makerspet/pcb/pico_breakout_head/README.md

# Raspberry Pi Pico Head Breakout PCB for Maker's Pet robots

## Files
- [schematic PDF](output/pico_breakout_head_schematic.pdf)
- [BoM .CSV](output/pico_breakout_head_bom.csv), [BoM .XML](output/pico_breakout_head_bom.xml)
- [Gerber .ZIP](output/pico_breakout_head_gerber.zip)
- [3D model .STEP](output/pico_breakout_head.step)
- KiCAD schematic, layout - in this folder

## Top
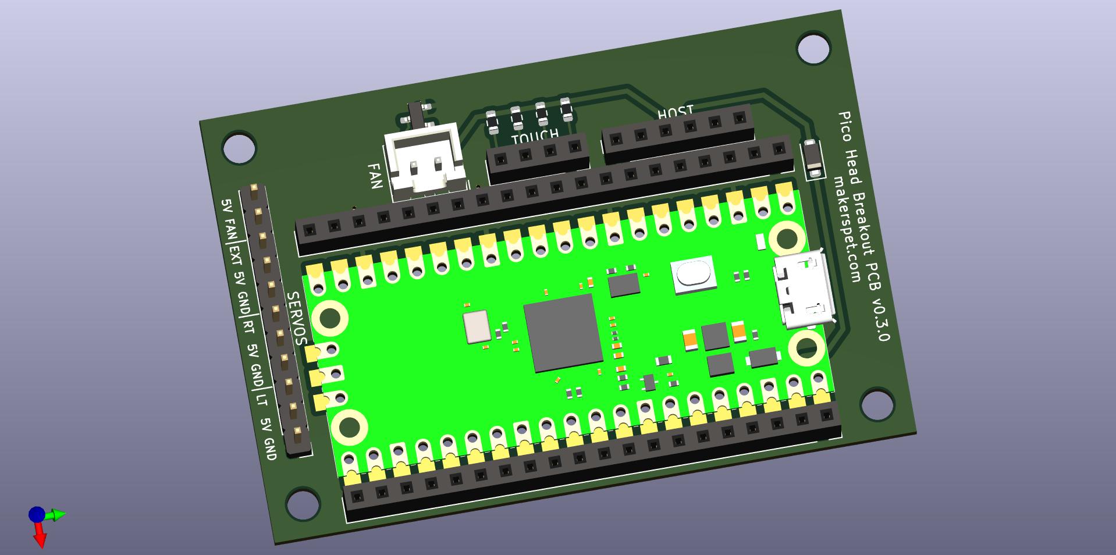
[picture p1: pico_breakout_head/output/pico_breakout_head_top.jpg]


## Bottom
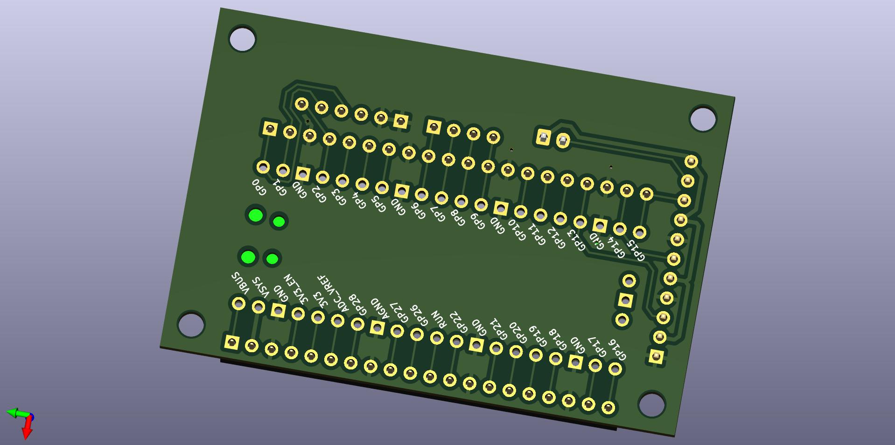
[picture p2: pico_breakout_head/output/pico_breakout_head_bottom.jpg]


# Change log

## v0.3.0
- DuPont host connector
- single side assembly
- alternative fan DuPont connection

## v0.2.1
- changed host connector from JST PH to JST ZH
- bugfix servo, touch sockets to headers

## v0.2.0
- fan N-MOSFET fix
- removed fan diode
  - unnecessary for such a small motor

## v0.1.1
- use same diode components
- removed fan MOSFET gate resistor

## v0.1
- I2C host interface connector
- fan connector
- connector for 3 servos
  - left and right ears plus one extra
- touch connector with 4 segments
