makerspet/pcb/lds02rr_adapter/README.md

# Adapter PCB for LDS02RR laser distance scanner

Connect these LiDARs/LDS to Arduino to capture laser distance data:
- Xiaomi LDS02RR
- Xiaomi LDS01RR

This PCB implements PWM motor control for LDS02RR, LDS01RR. Find
sample Arduino ESP32 firmware code [here](https://github.com/kaiaai/LDS02RR_ESP32).

## Files
- [schematic PDF](output/LDS02RR_adapter_schematic.pdf)
- [BoM .CSV](output/LDS02RR_adapter_BoM.csv), [BoM .XML](output/LDS02RR_adapter_BoM.xml)
- [Gerber .ZIP](output/LDS02RR_adapter_gerber.zip)
- [3D model .STEP](output/LDS02RR_adapter.step)
- KiCAD schematic, layout - in this folder

<a href="http://www.youtube.com/watch?feature=player_embedded&v=Wes9GYomUdE" target="_blank">
 Xiaomi LDS02RR streams live data to ROS2 using Arduino ESP32 and Micro-ROS
</a>

## Top
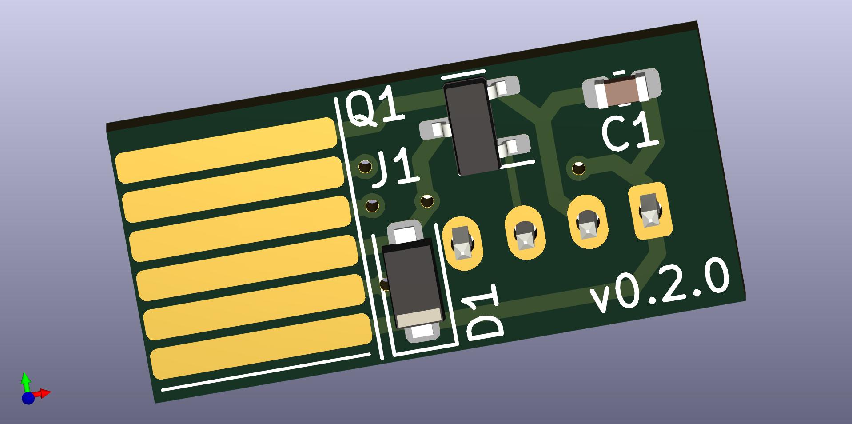
[picture p7: lds02rr_adapter/output/LDS02RR_adapter_top.jpg]


## Bottom
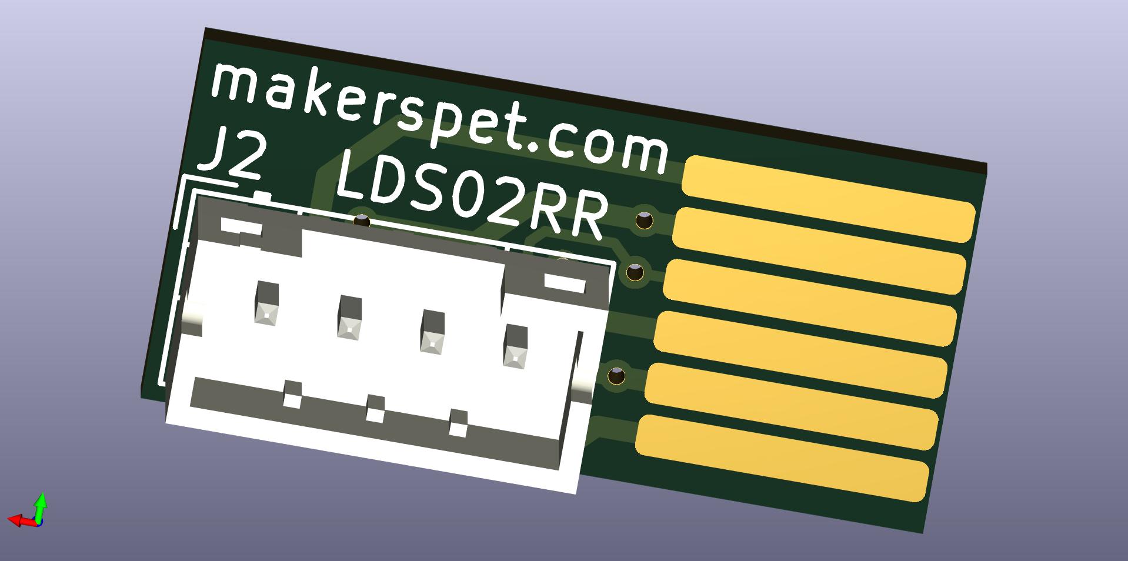
[picture p8: lds02rr_adapter/output/LDS02RR_adapter_bottom.jpg]


# Change log

## v0.2.1
- changed bypass cap from 100uF 1206 to 22uf 0603

## v0.2.0
- added a bypass cap

## v0.1.0
- initial prototype
- PCB inserts into LDS02RR connector
- 4-pin JST PH connector - 5V, GND, LDS motor PWM, LDS TX
