makerspet/pcb/esp32_combined_terminals/output/esp32_combined_bottom.jpg

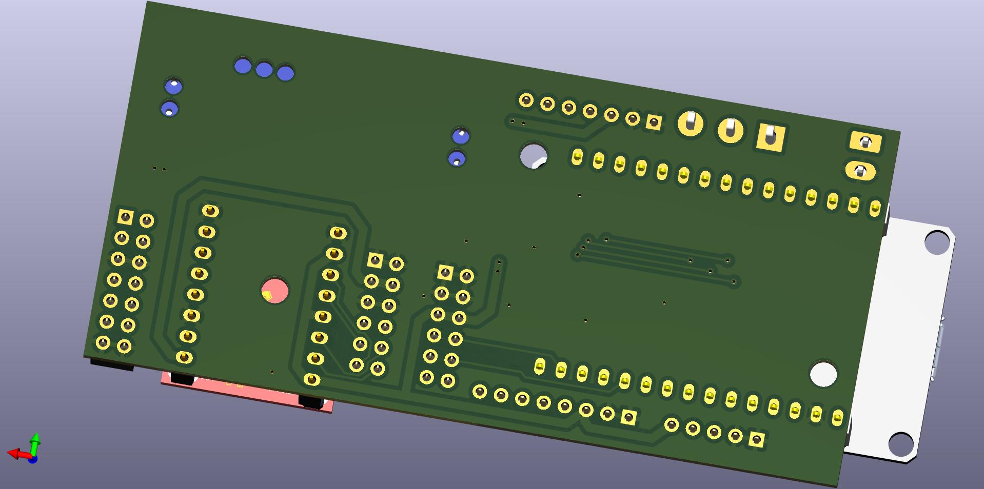
esp32_combined_terminals/output/esp32_combined_bottom.jpg
