makerspet/pcb/esp32_combined_terminals/output/esp32_combined_top.jpg

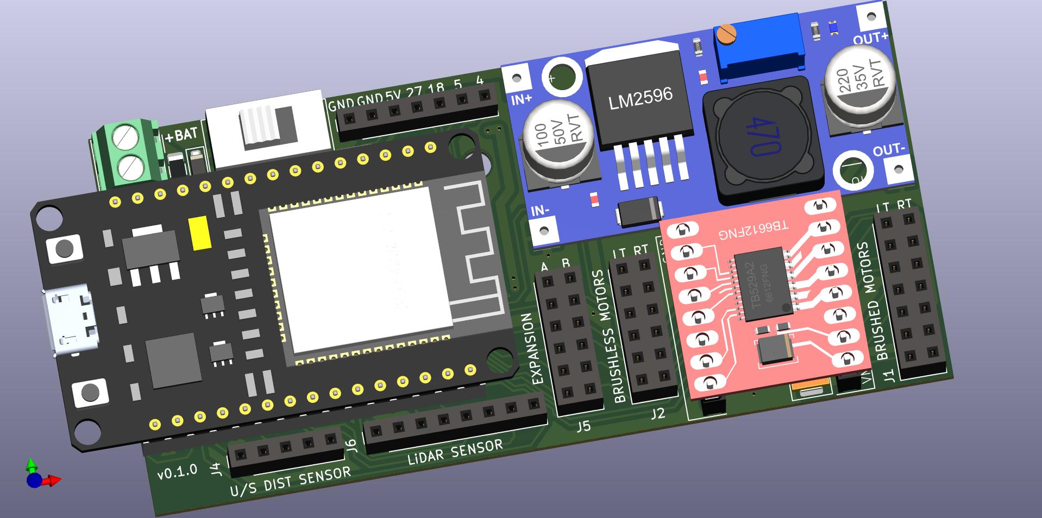
esp32_combined_terminals/output/esp32_combined_top.jpg
