makerspet/pcb/mini_/output/esp32_combo_bottom.jpg

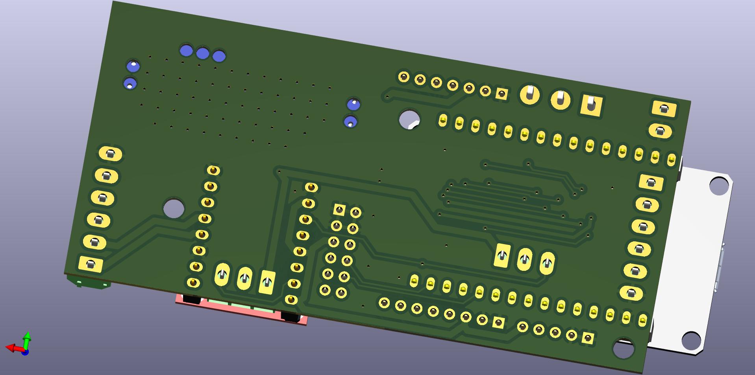
mini_/output/esp32_combo_bottom.jpg
