makerspet/pcb/hls_adapter/output/hls_adapter.step

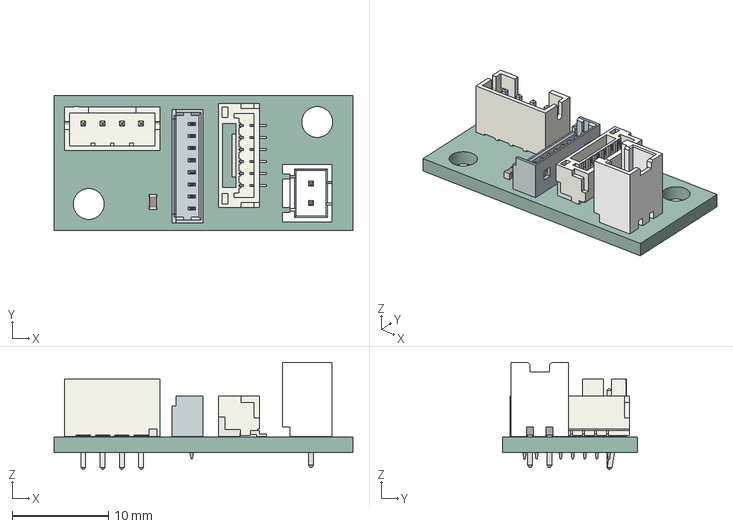
[picture p12: CAD file, 2024-03-07]
hls_adapter/output/hls_adapter.step
31.0 x 14.0 x 11.1 mm
hls_adapter PCB
