makerspet/pcb/lds02rr_adapter/output/LDS02RR_adapter.step

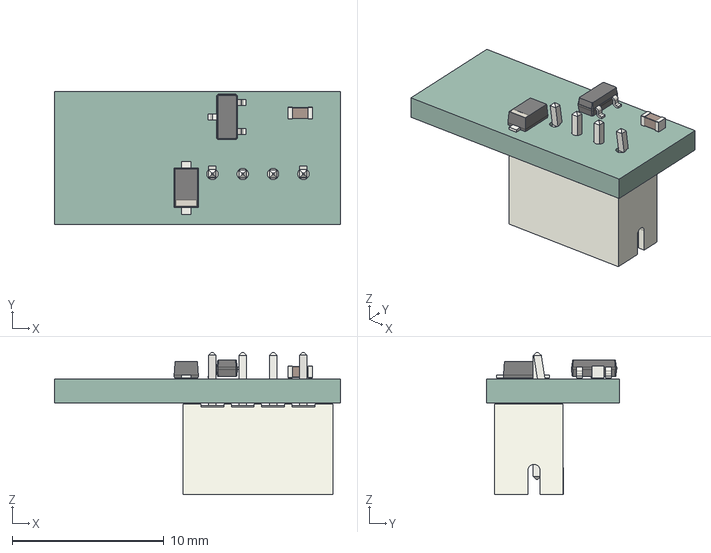
[picture p13: CAD file, 2024-03-07]
lds02rr_adapter/output/LDS02RR_adapter.step
18.9 x 8.80 x 9.40 mm
LDS02RR_adapter PCB
