makerspet/pcb/step/PCB_Terminal_Block_2-P3.5.step

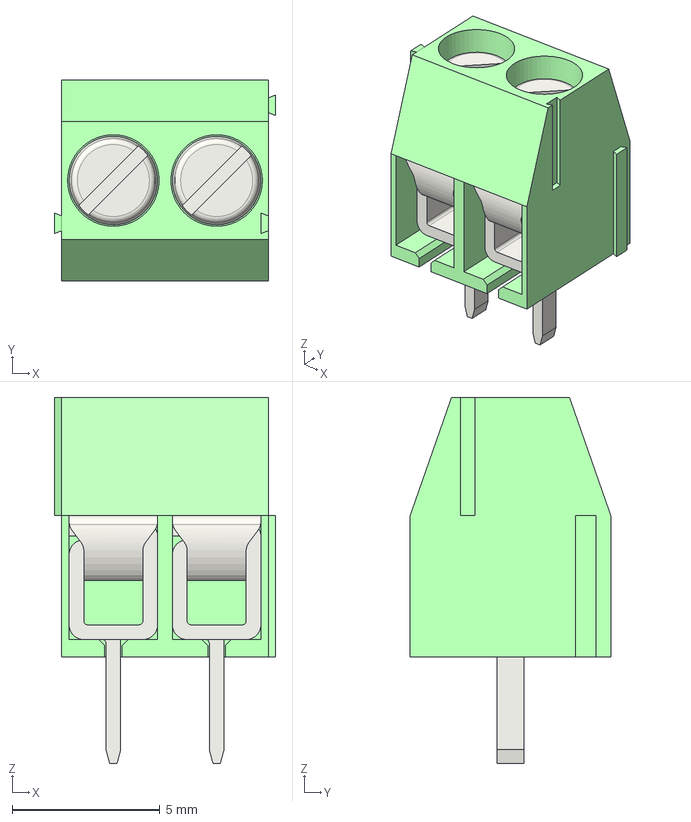
[picture p14: CAD file, 2024-04-06]
step/PCB_Terminal_Block_2-P3.5.step
7.50 x 6.80 x 12.4 mm
M1.6x4-Screw030
