makerspet/pcb/step/PCB_Terminal_Block_6-P3.5.step

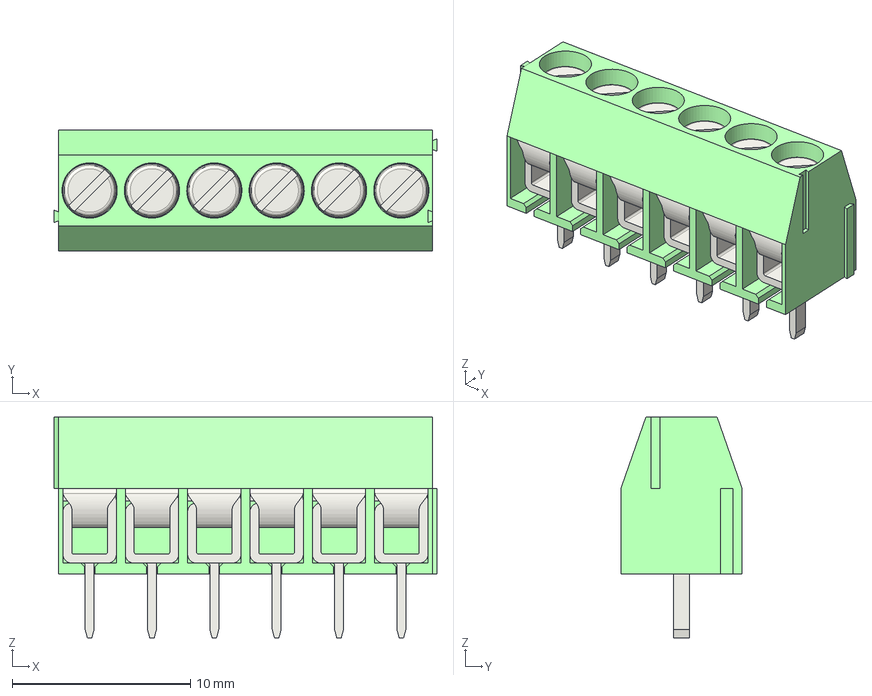
[picture p15: CAD file, 2024-04-06]
step/PCB_Terminal_Block_6-P3.5.step
21.5 x 6.80 x 12.4 mm
M1.6x4-Screw038
