makerspet/pcb/step/PCB Terminal Block 2 DEG381-3.5.step

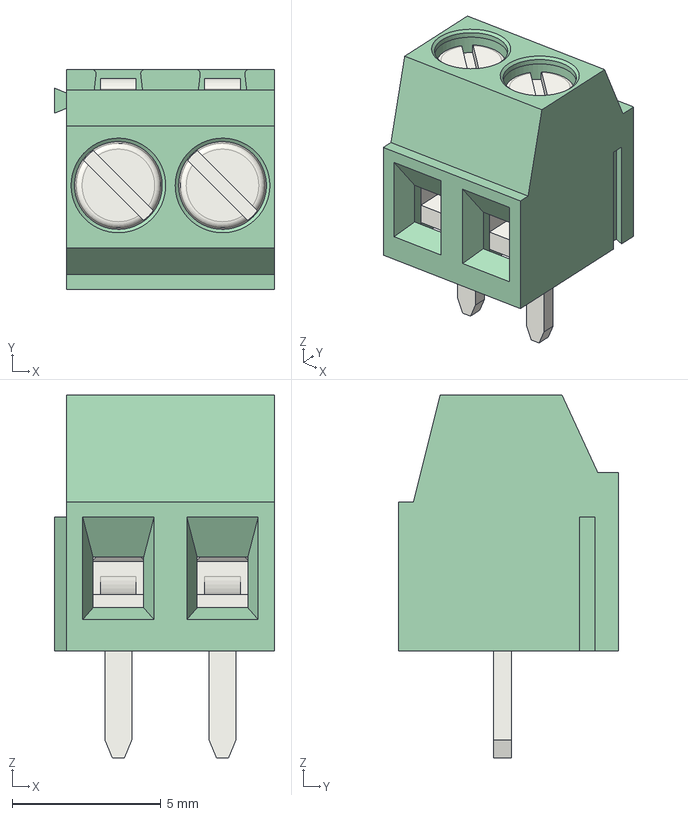
[picture p18: CAD file, 2024-03-29]
step/PCB Terminal Block 2 DEG381-3.5.step
7.40 x 7.40 x 12.2 mm
Plastic Housing001
Pin 002
Clamp Block001
M1.6x3-Screw001
