makerspet/pcb/step/Molex_PicoBlade_53047_0810.stp

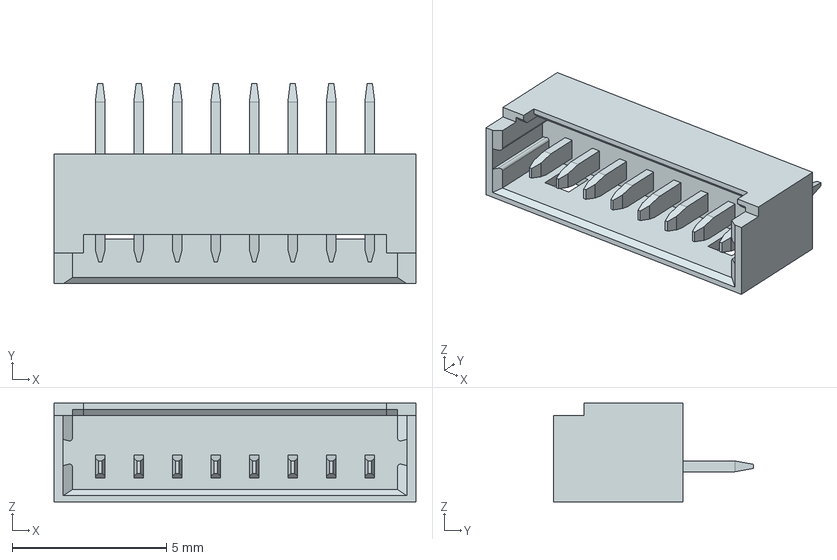
[picture p19: CAD file, 2024-02-16]
step/Molex_PicoBlade_53047_0810.stp
11.8 x 6.50 x 3.20 mm
