makerspet/pcb/step/smw200-02-socket-th-vertical.stp

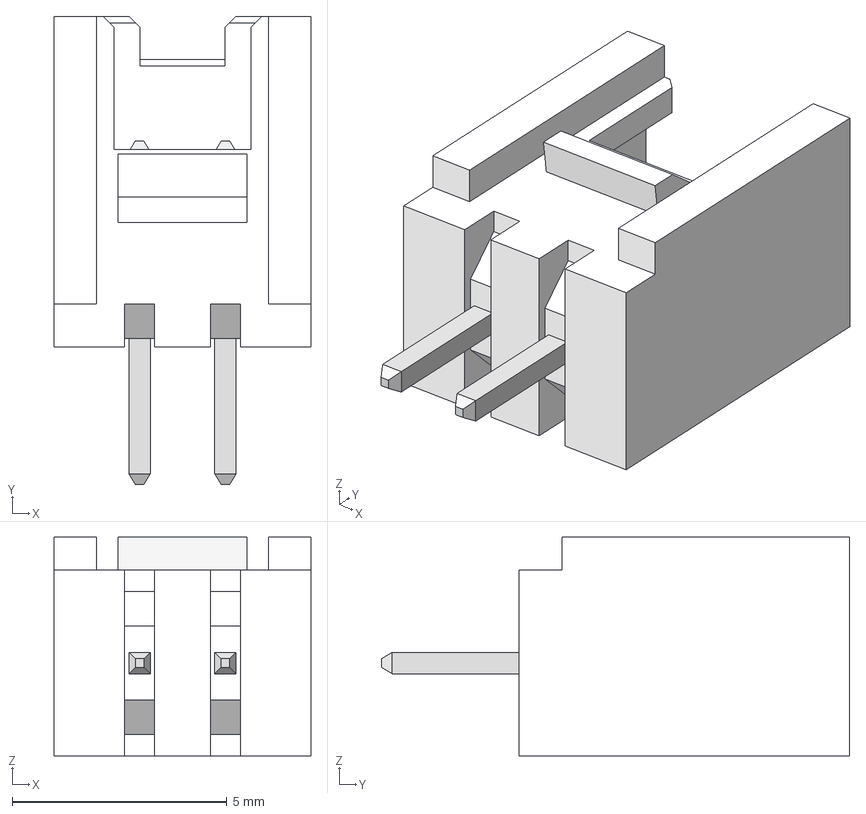
[picture p20: CAD file, 2024-02-13]
step/smw200-02-socket-th-vertical.stp
5.98 x 10.9 x 5.10 mm
