makerspet/pcb/step/SS14LW.step

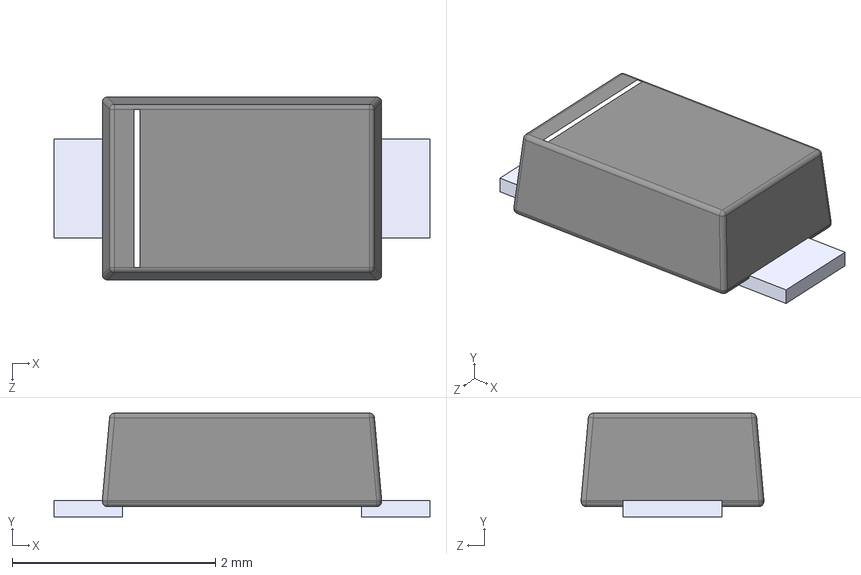
[picture p21: CAD file, 2024-01-23]
step/SS14LW.step
3.70 x 1.02 x 1.80 mm
