makerspet/pcb/step/JST-B11B-ZR.step

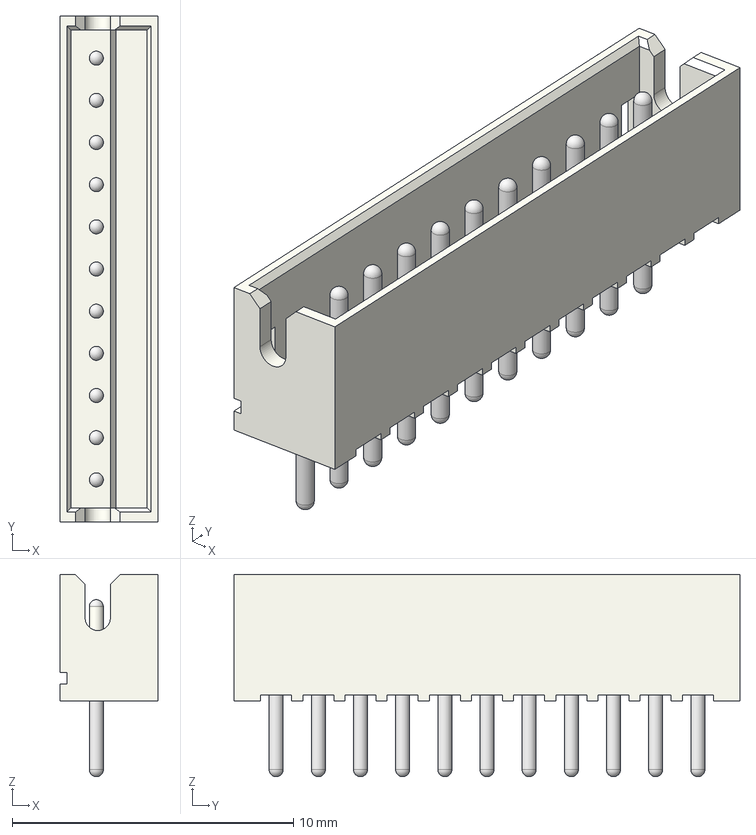
[picture p22: CAD file, 2024-01-23]
step/JST-B11B-ZR.step
3.50 x 18.0 x 7.20 mm
