makerspet/pcb/step/kicad_module_3D_MINI560.step

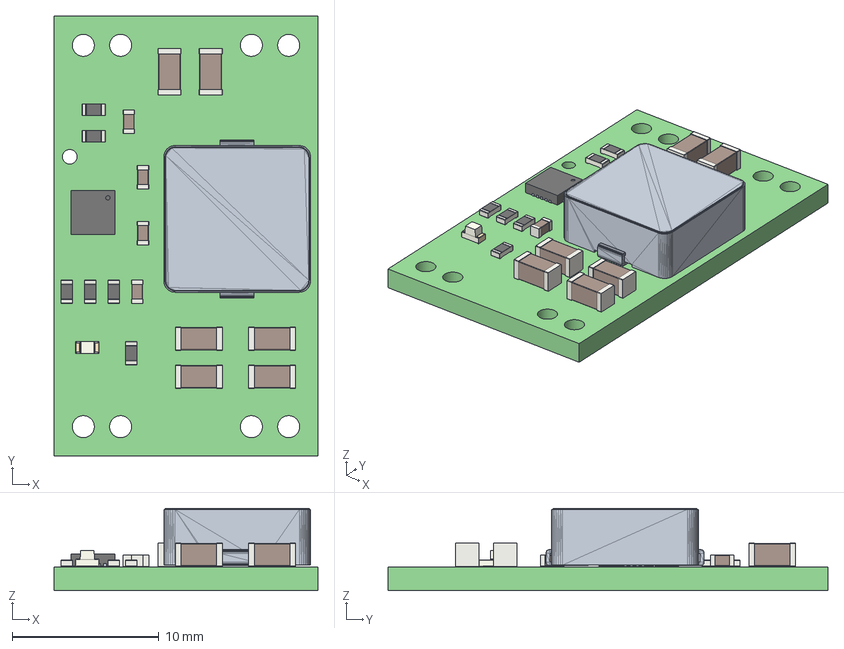
[picture p23: CAD file, 2024-01-23]
step/kicad_module_3D_MINI560.step
18.0 x 30.0 x 5.62 mm
kicad_module_3D_MINI560 PCB
