makerspet/pcb/step/JST-B5B-ZR.step

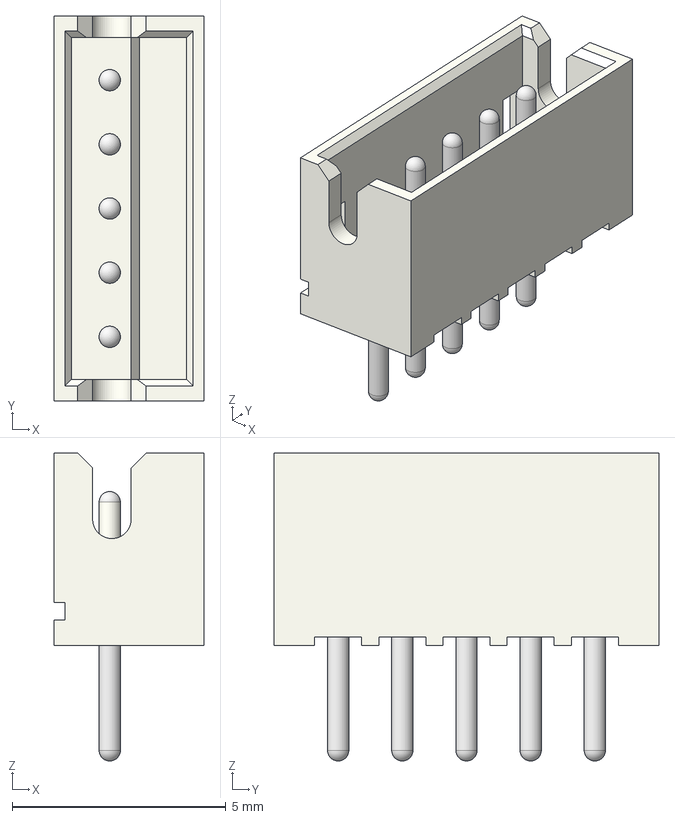
[picture p24: CAD file, 2024-01-23]
step/JST-B5B-ZR.step
3.50 x 9.00 x 7.20 mm
