makerspet/pcb/step/JST-B7B-ZR.step

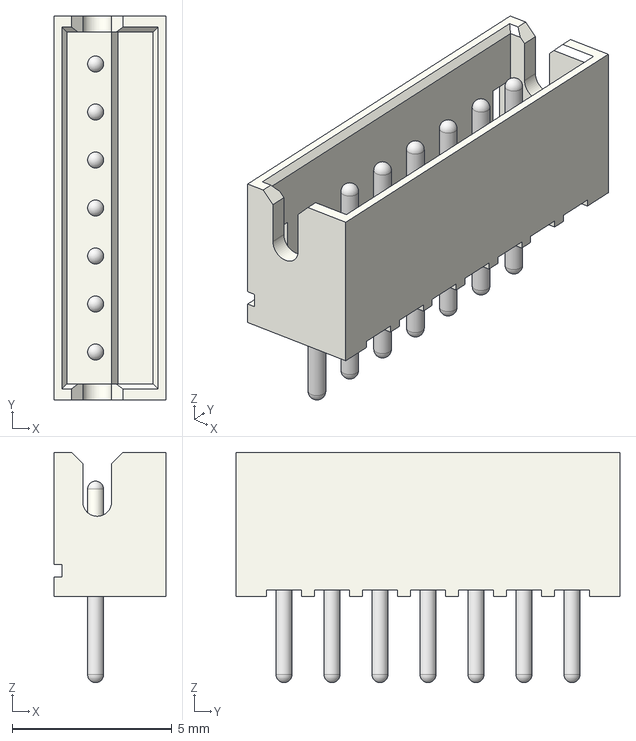
[picture p25: CAD file, 2024-01-23]
step/JST-B7B-ZR.step
3.50 x 12.0 x 7.20 mm
