makerspet/pcb/step/T-Plug male - W.S Deans Co. Est. 1957.step

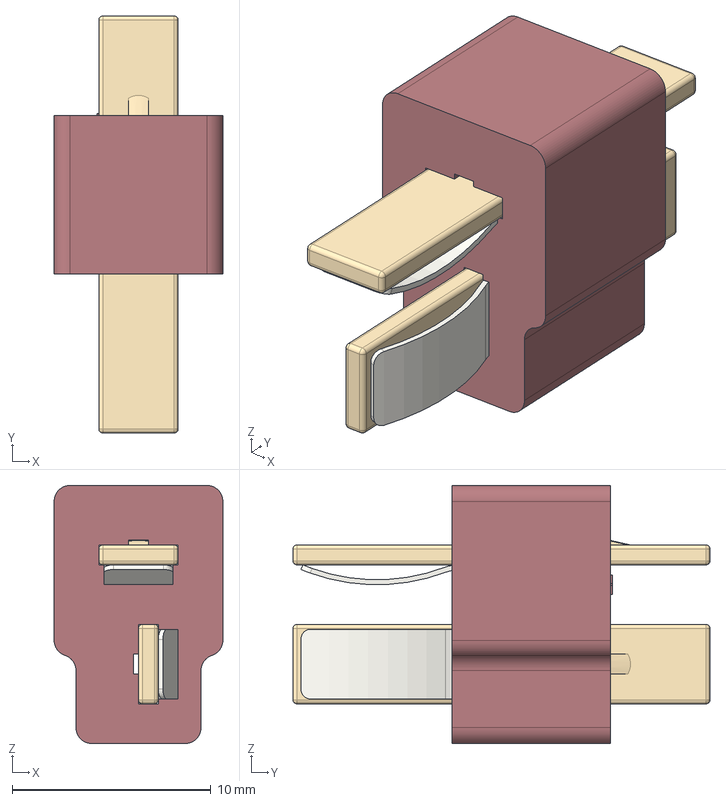
[picture p26: CAD file, 2024-01-23]
step/T-Plug male - W.S Deans Co. Est. 1957.step
8.50 x 21.0 x 13.0 mm
