makerspet/pcb/step/T-Plug female - W.S Deans Co. Est. 1957.step

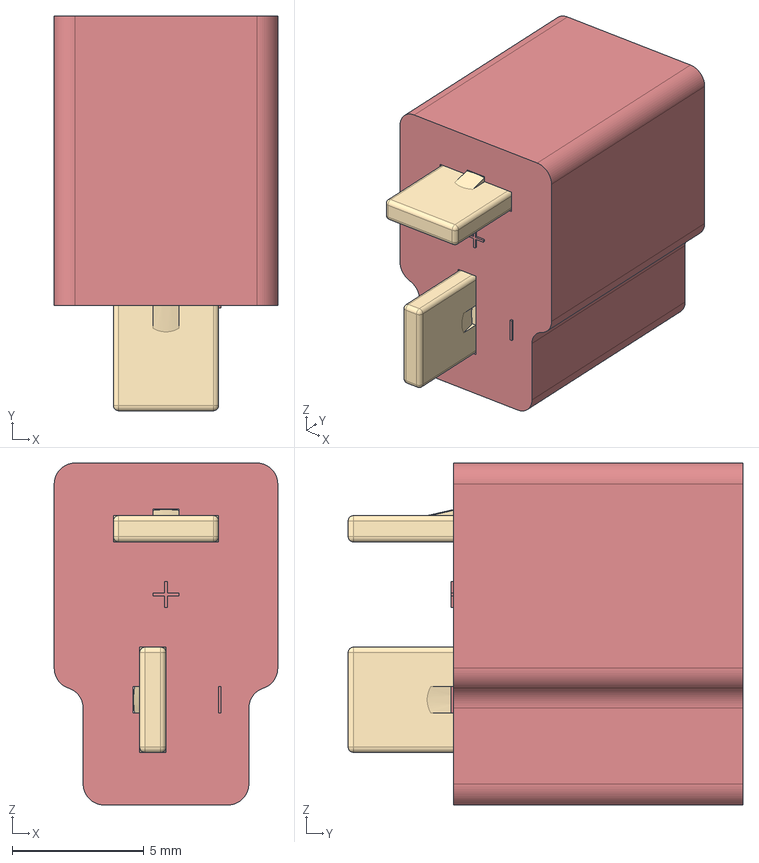
[picture p27: CAD file, 2024-01-23]
step/T-Plug female - W.S Deans Co. Est. 1957.step
8.50 x 15.0 x 13.0 mm
