makerspet/pcb/step/JST-B3B-ZR.step

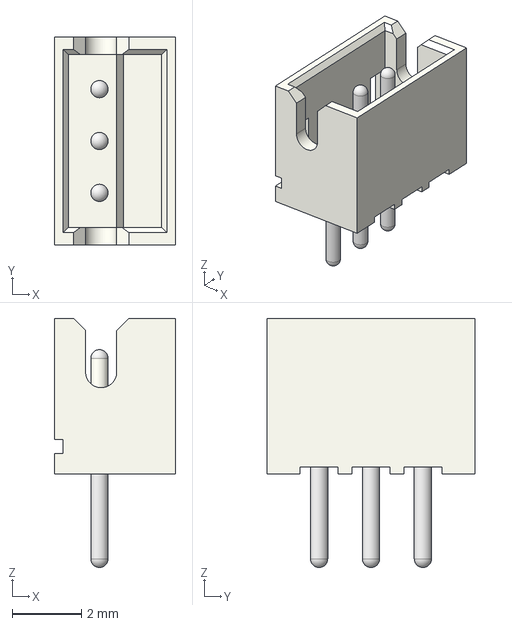
[picture p28: CAD file, 2024-01-23]
step/JST-B3B-ZR.step
3.50 x 6.00 x 7.20 mm
