makerspet/pcb/step/JST-B12B-ZR.step

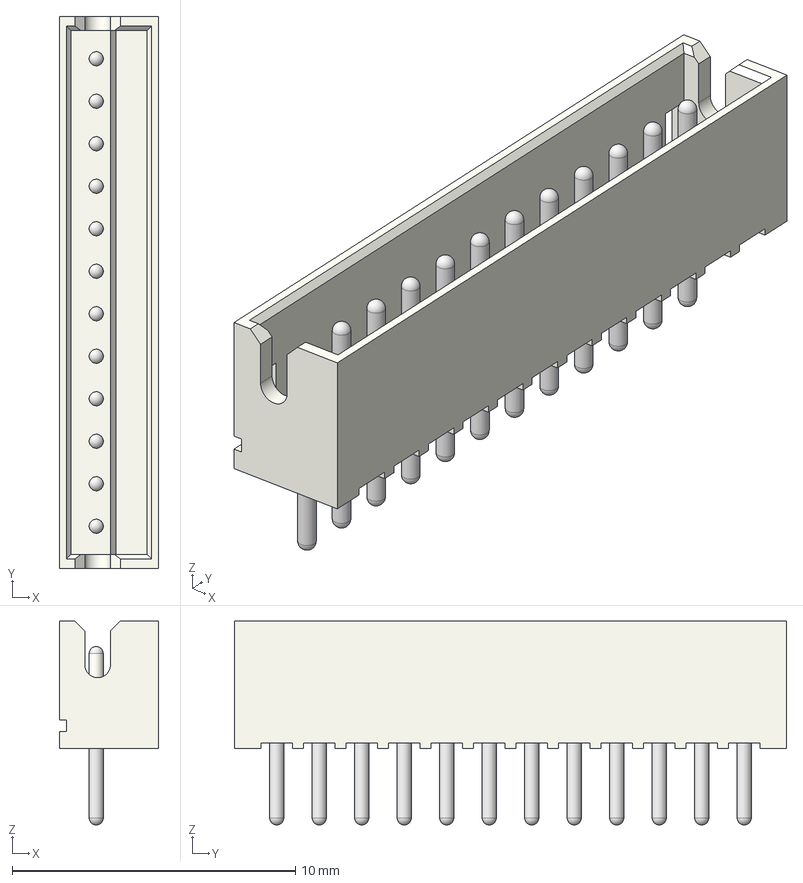
[picture p29: CAD file, 2024-01-23]
step/JST-B12B-ZR.step
3.50 x 19.5 x 7.20 mm
