makerspet/pcb/step/JST-B6B-ZR.step

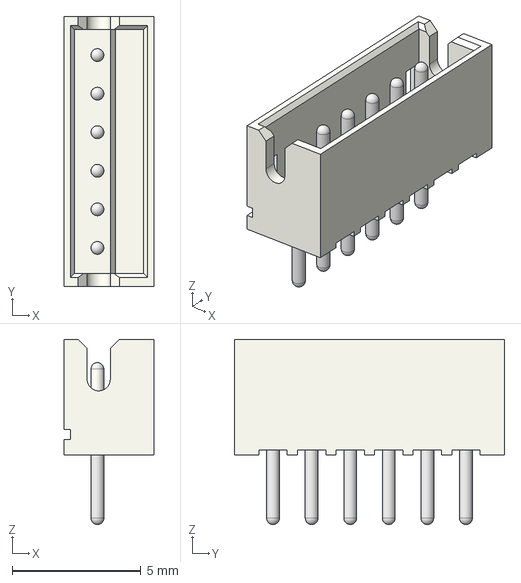
[picture p30: CAD file, 2024-01-23]
step/JST-B6B-ZR.step
3.50 x 10.5 x 7.20 mm
