makerspet/pcb/step/SS-12D10L4.STEP

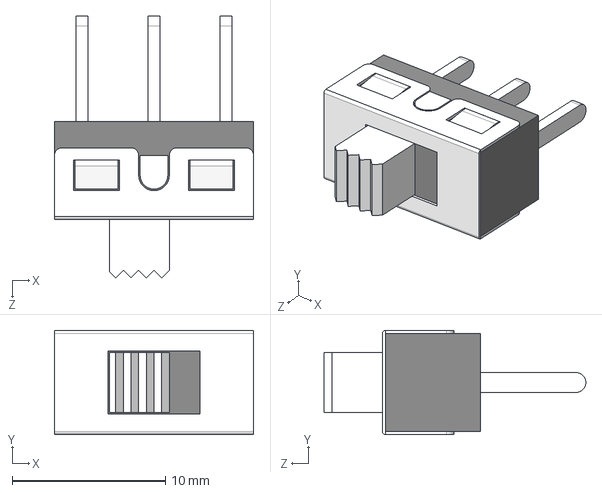
[picture p31: CAD file, 2024-01-23]
step/SS-12D10L4.STEP
13.0 x 6.80 x 17.1 mm
