makerspet/pcb/step/JST-B13B-ZR.step

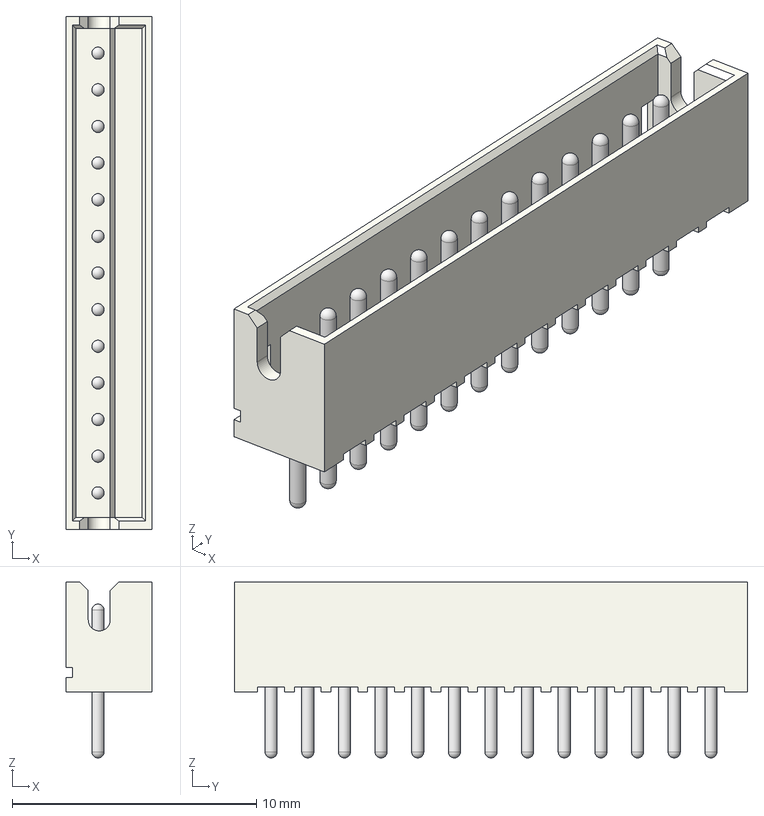
[picture p32: CAD file, 2024-01-23]
step/JST-B13B-ZR.step
3.50 x 21.0 x 7.20 mm
