makerspet/pcb/step/XT30U-M.step

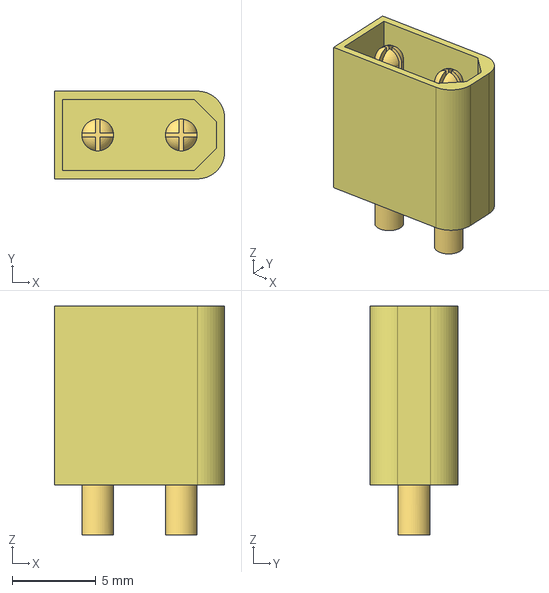
[picture p33: CAD file, 2024-01-23]
step/XT30U-M.step
10.2 x 5.25 x 13.7 mm
