makerspet/pcb/step/JST-B10B-ZR.step

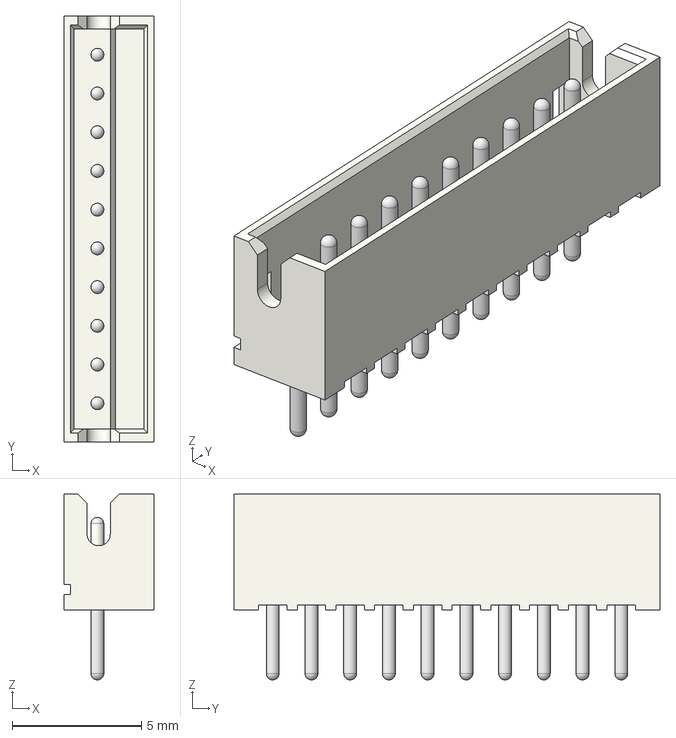
[picture p34: CAD file, 2024-01-23]
step/JST-B10B-ZR.step
3.50 x 16.5 x 7.20 mm
