makerspet/pcb/step/DC_Power_Jack_PCB_Mounted_2.1mm.step

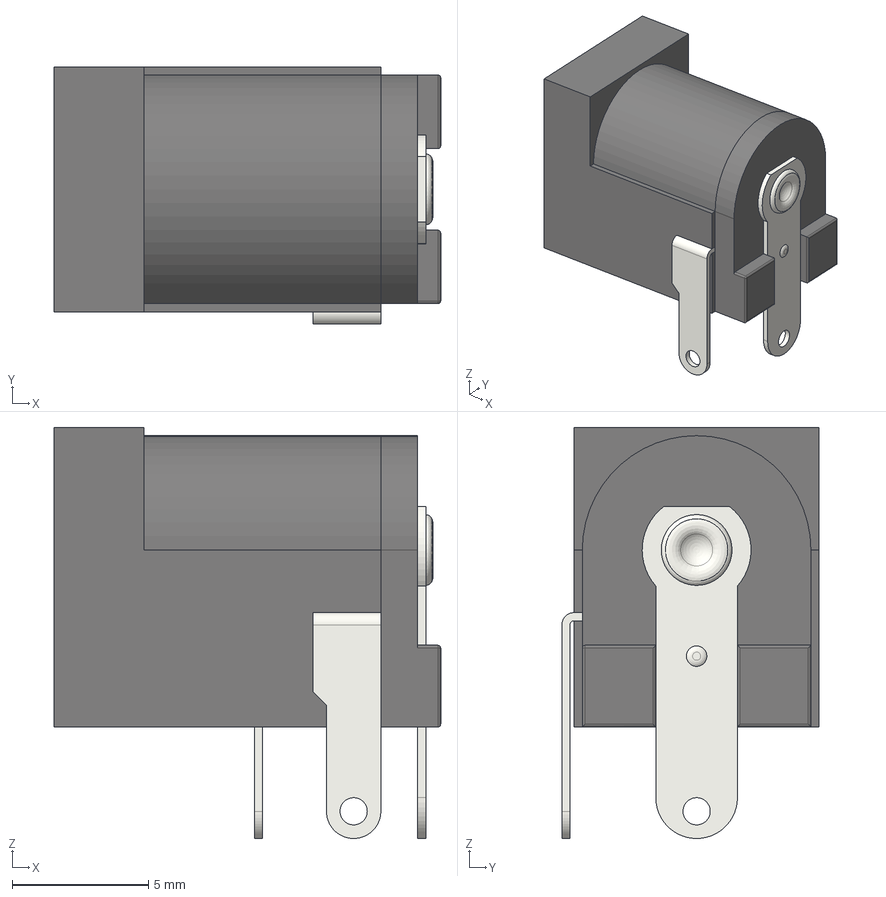
[picture p35: CAD file, 2024-01-23]
step/DC_Power_Jack_PCB_Mounted_2.1mm.step
14.2 x 9.45 x 15.1 mm
Plastic_Body_1of2
Plastic_Body_2of2
PIN_01
PIN_03
PIN_02
Boner
