makerspet/pcb/step/JST-B9B-ZR.step

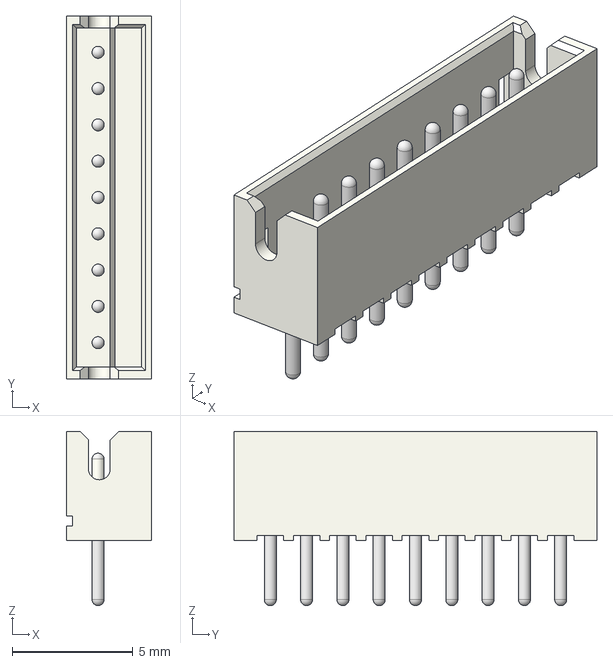
[picture p36: CAD file, 2024-01-23]
step/JST-B9B-ZR.step
3.50 x 15.0 x 7.20 mm
