makerspet/pcb/step/JST-B2B-ZR.step

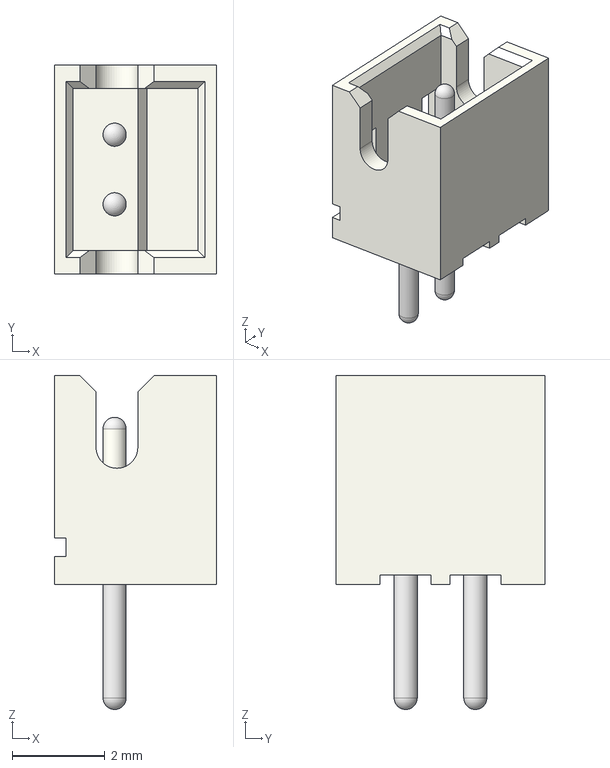
[picture p37: CAD file, 2024-01-23]
step/JST-B2B-ZR.step
3.50 x 4.50 x 7.20 mm
