makerspet/pcb/step/JST-B8B-ZR.step

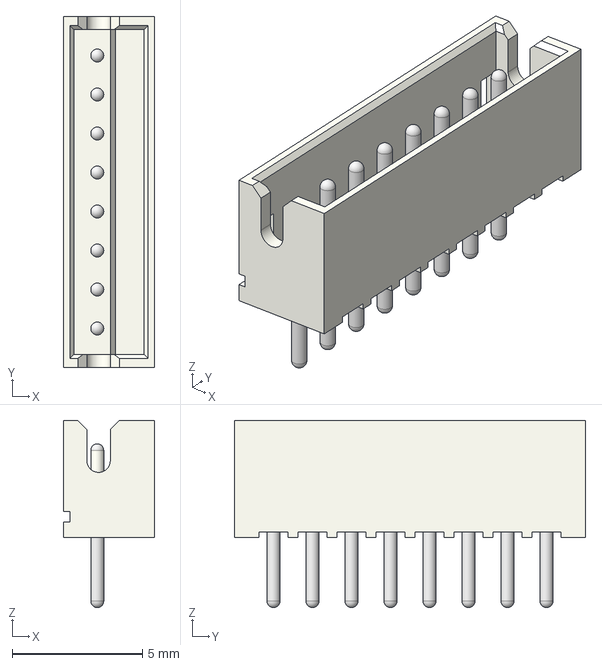
[picture p38: CAD file, 2024-01-23]
step/JST-B8B-ZR.step
3.50 x 13.5 x 7.20 mm
