makerspet/pcb/step/LM2596 DC-DC StepDown Converter v1.step

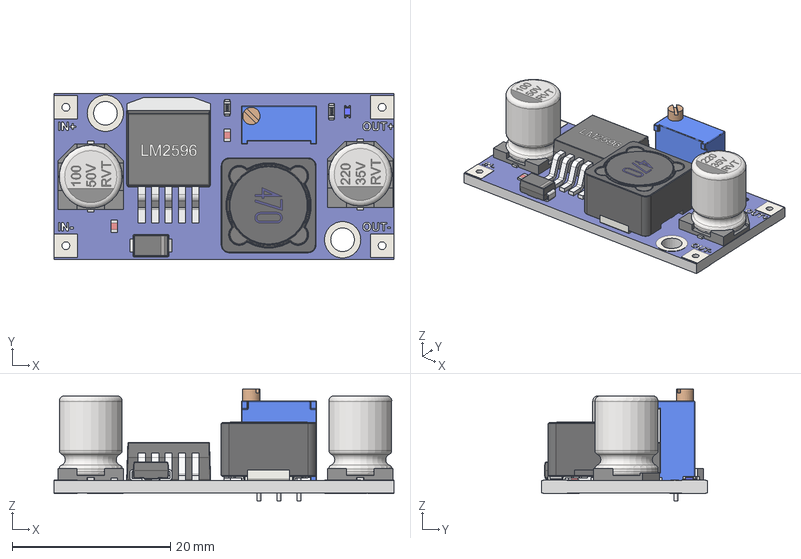
[picture p39: CAD file, 2024-01-23]
step/LM2596 DC-DC StepDown Converter v1.step
43.0 x 21.0 x 14.2 mm
Board v5
Trimpot 3296W v1
CDRH127_470M v1
CAPSMD220-35 v1
CAPSMD100-50 v1
TO-263BA v2
DO-214AC-DIOM5127X23N v1
Resistor 0603 v1
Resistor 0603 v1 (1)
CAP0603 v1
LED Blue SMD 0603 Würth 150060BS55040 v1
CAP0603 v1 (1)
