makerspet/pcb/step/DCJ200-10-A-K1-K--3DModel-STEP-740395.STEP

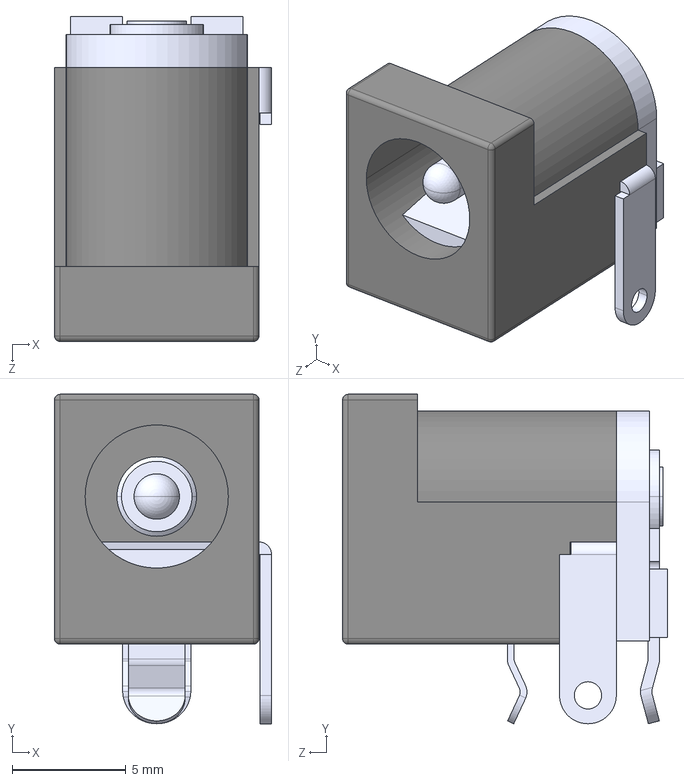
[picture p40: CAD file, 2024-01-23]
step/DCJ200-10-A-K1-K--3DModel-STEP-740395.STEP
9.55 x 14.5 x 14.3 mm
