makerspet/pcb/step/JST-B4B-ZR.step

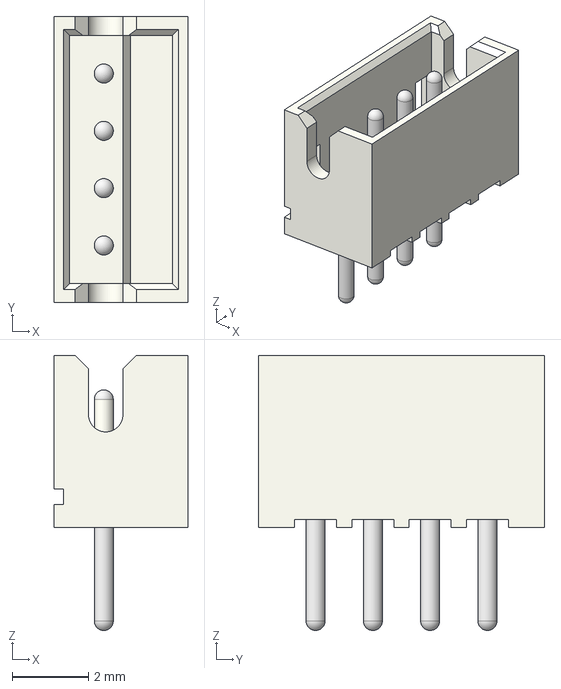
[picture p41: CAD file, 2024-01-23]
step/JST-B4B-ZR.step
3.50 x 7.50 x 7.20 mm
