makerspet/pcb/pico_breakout_head/output/pico_breakout_head_schematic.pdf

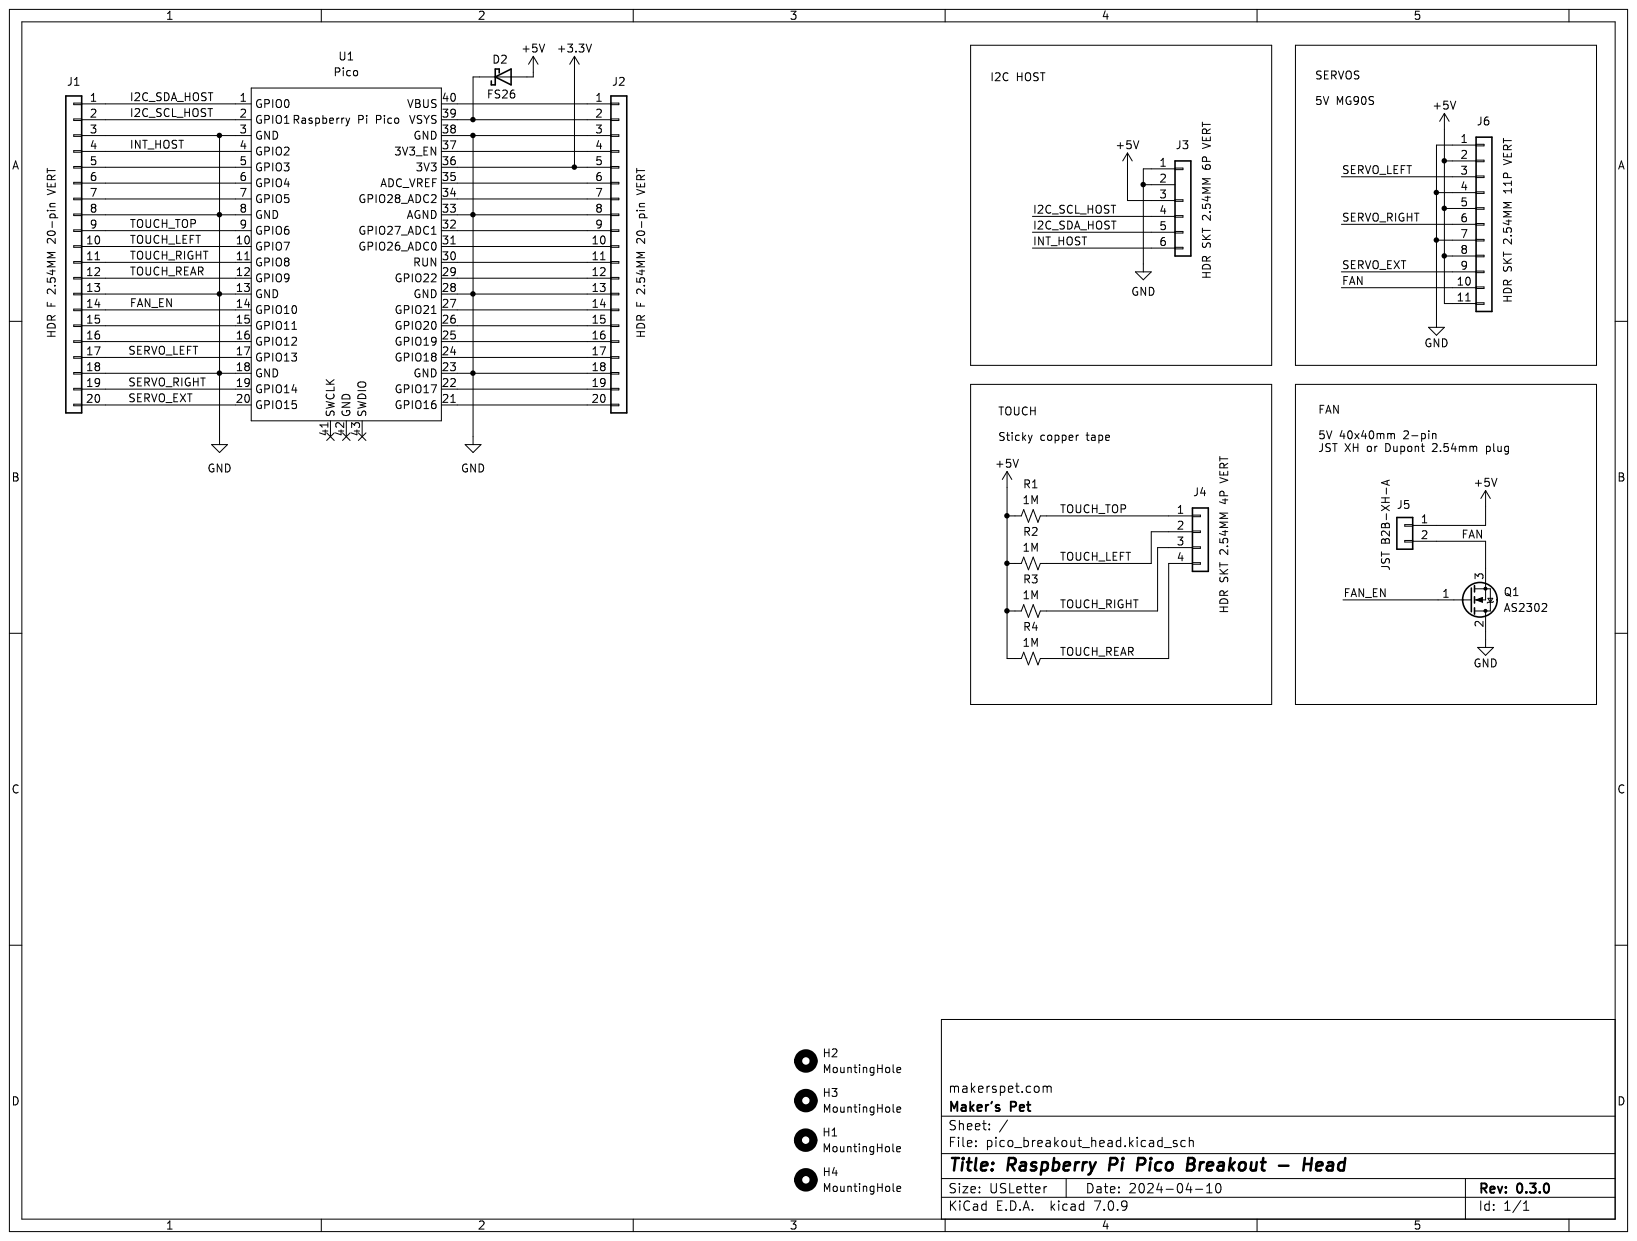
[picture p42: page 1]
