makerspet/pcb/mini_/output/esp32_combo_schematic.pdf

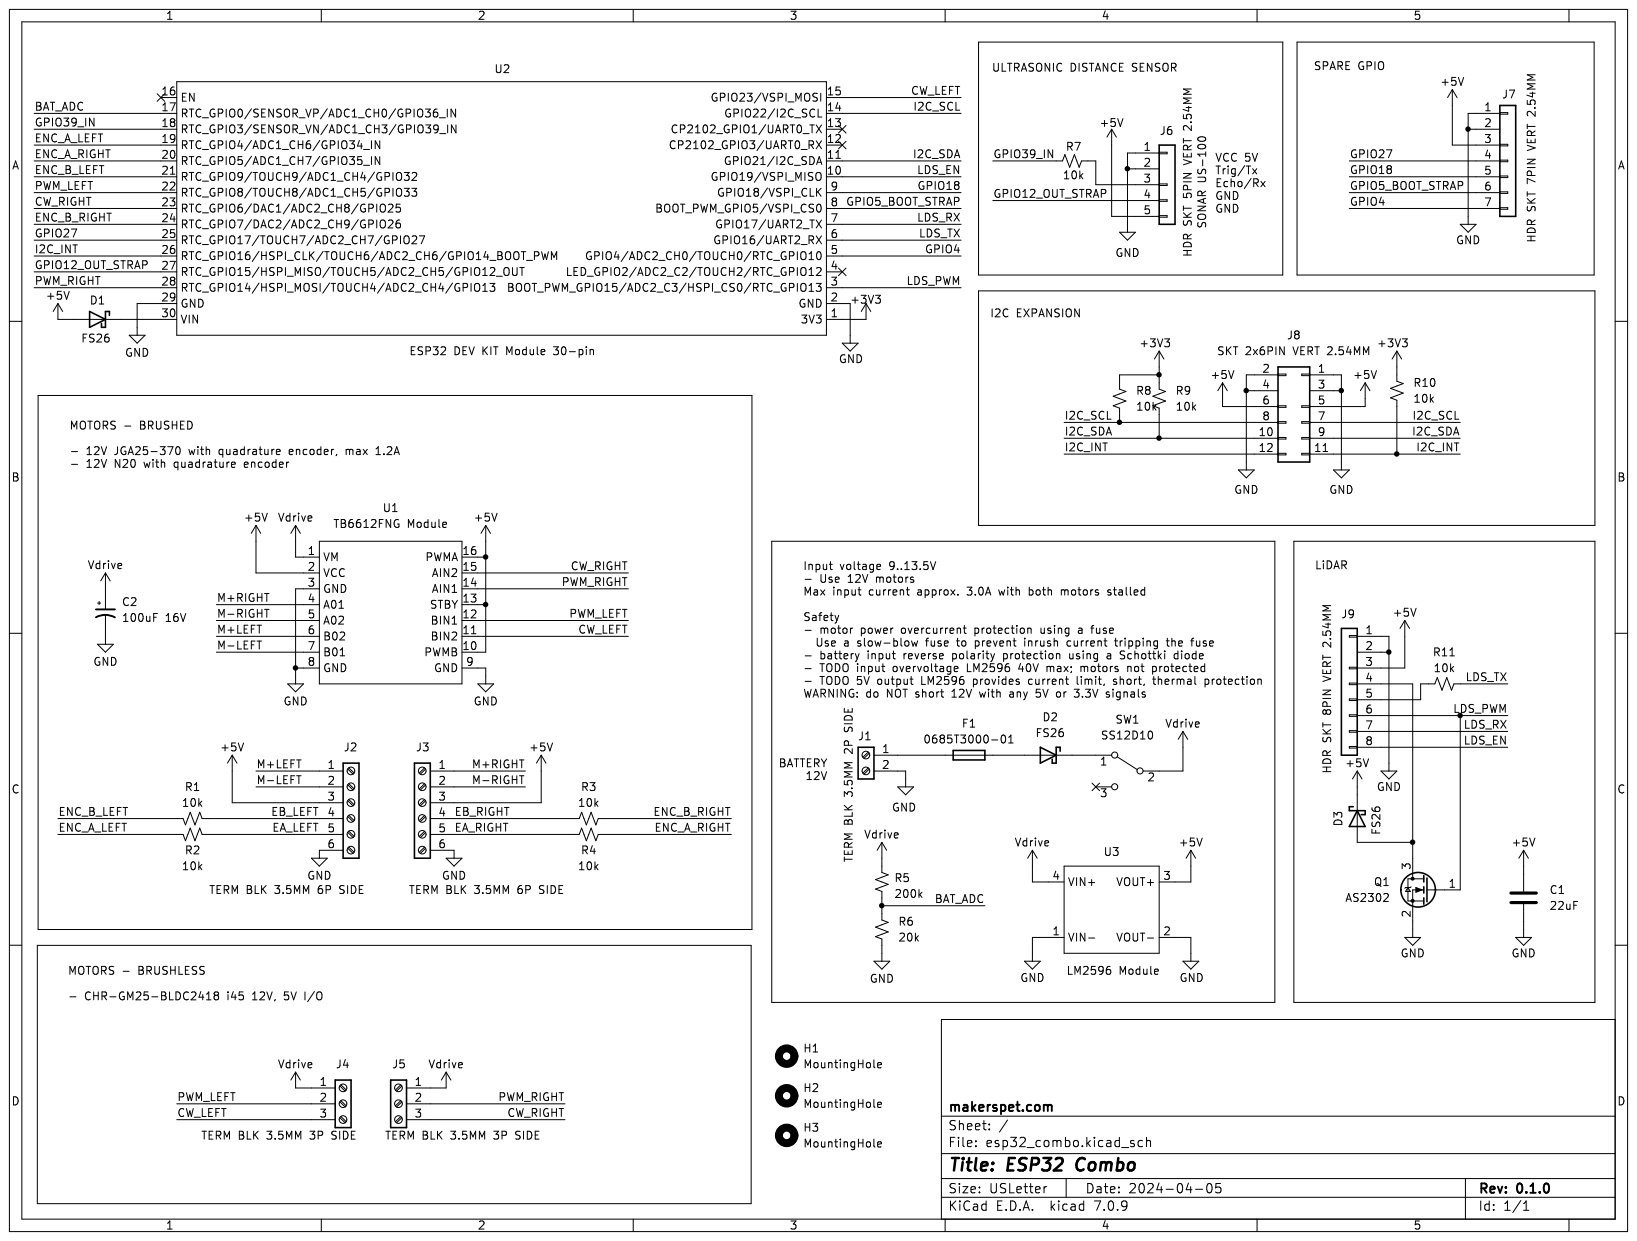
[picture p43: page 1]
