makerspet/pcb/esp32_combined_terminals/output/esp32_combined_schematic.pdf

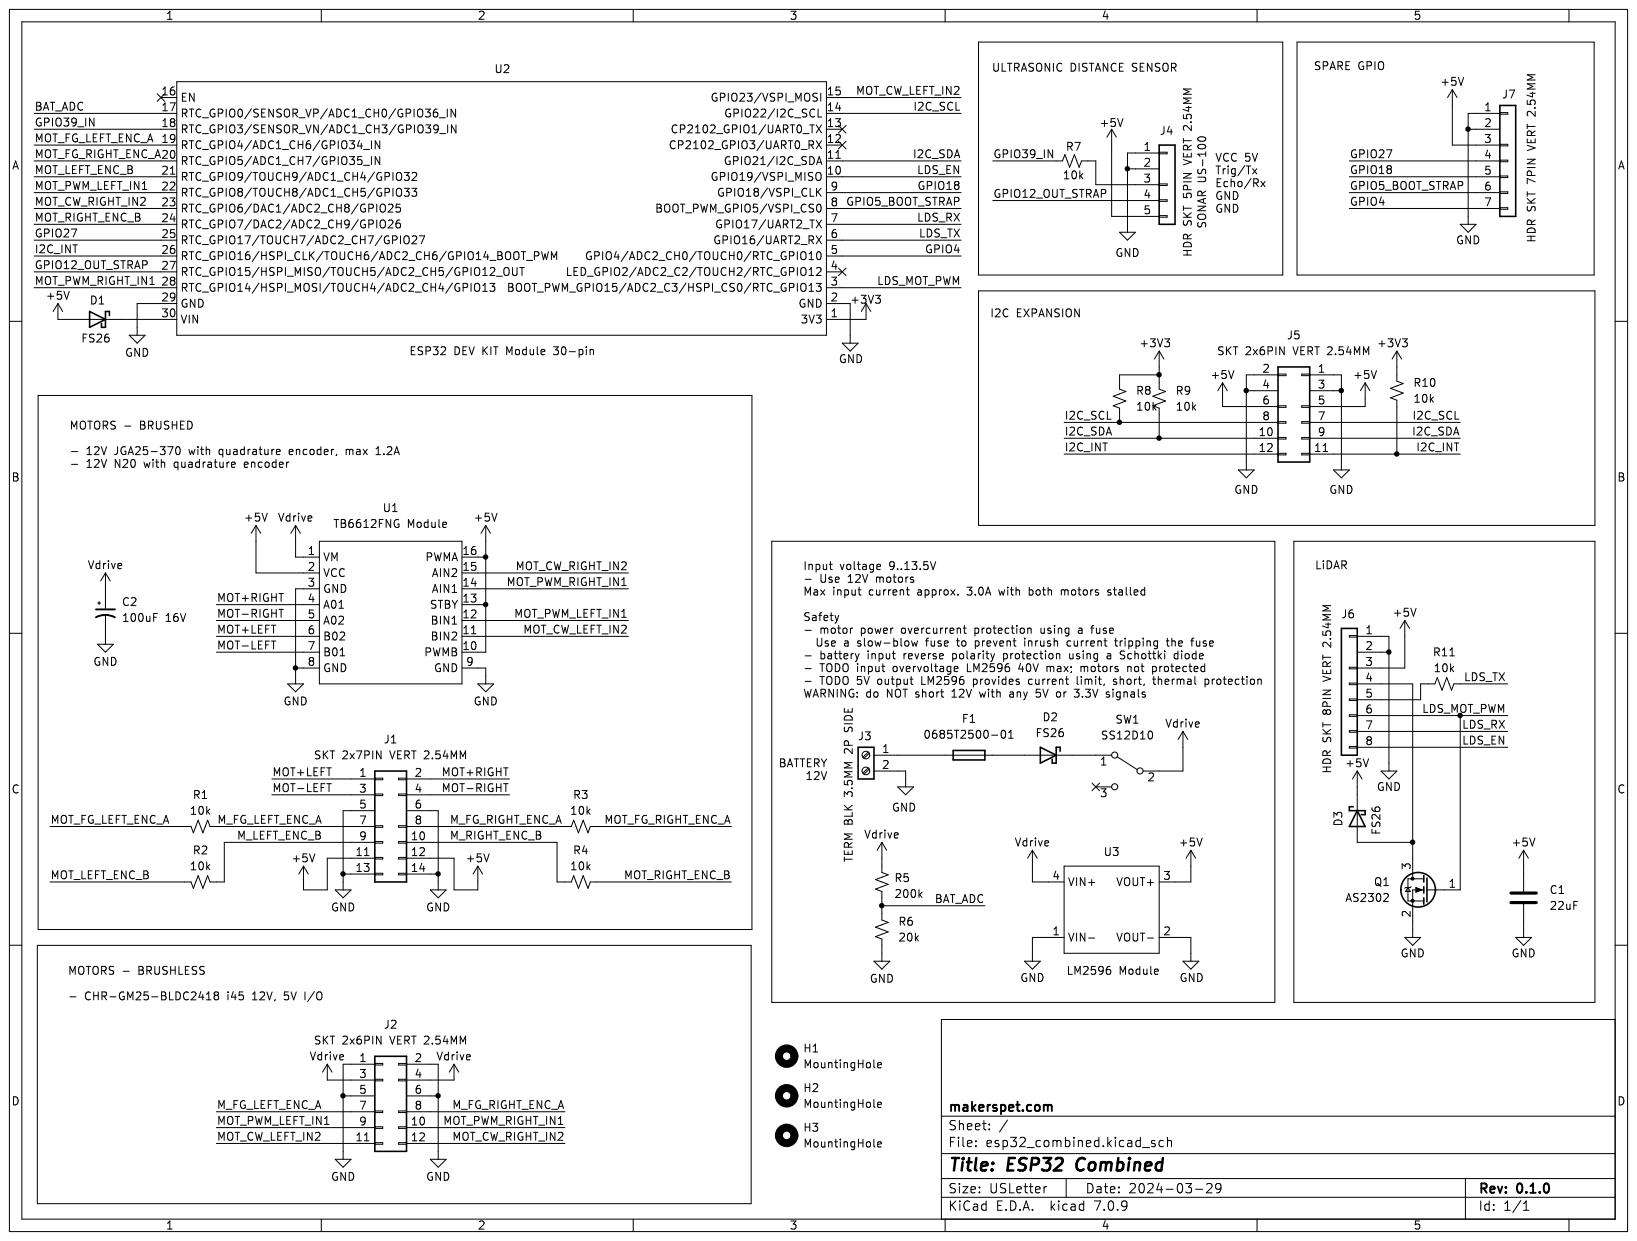
[picture p44: page 1]
