makerspet/pcb/hls_adapter/output/hls_adapter_schematic.pdf

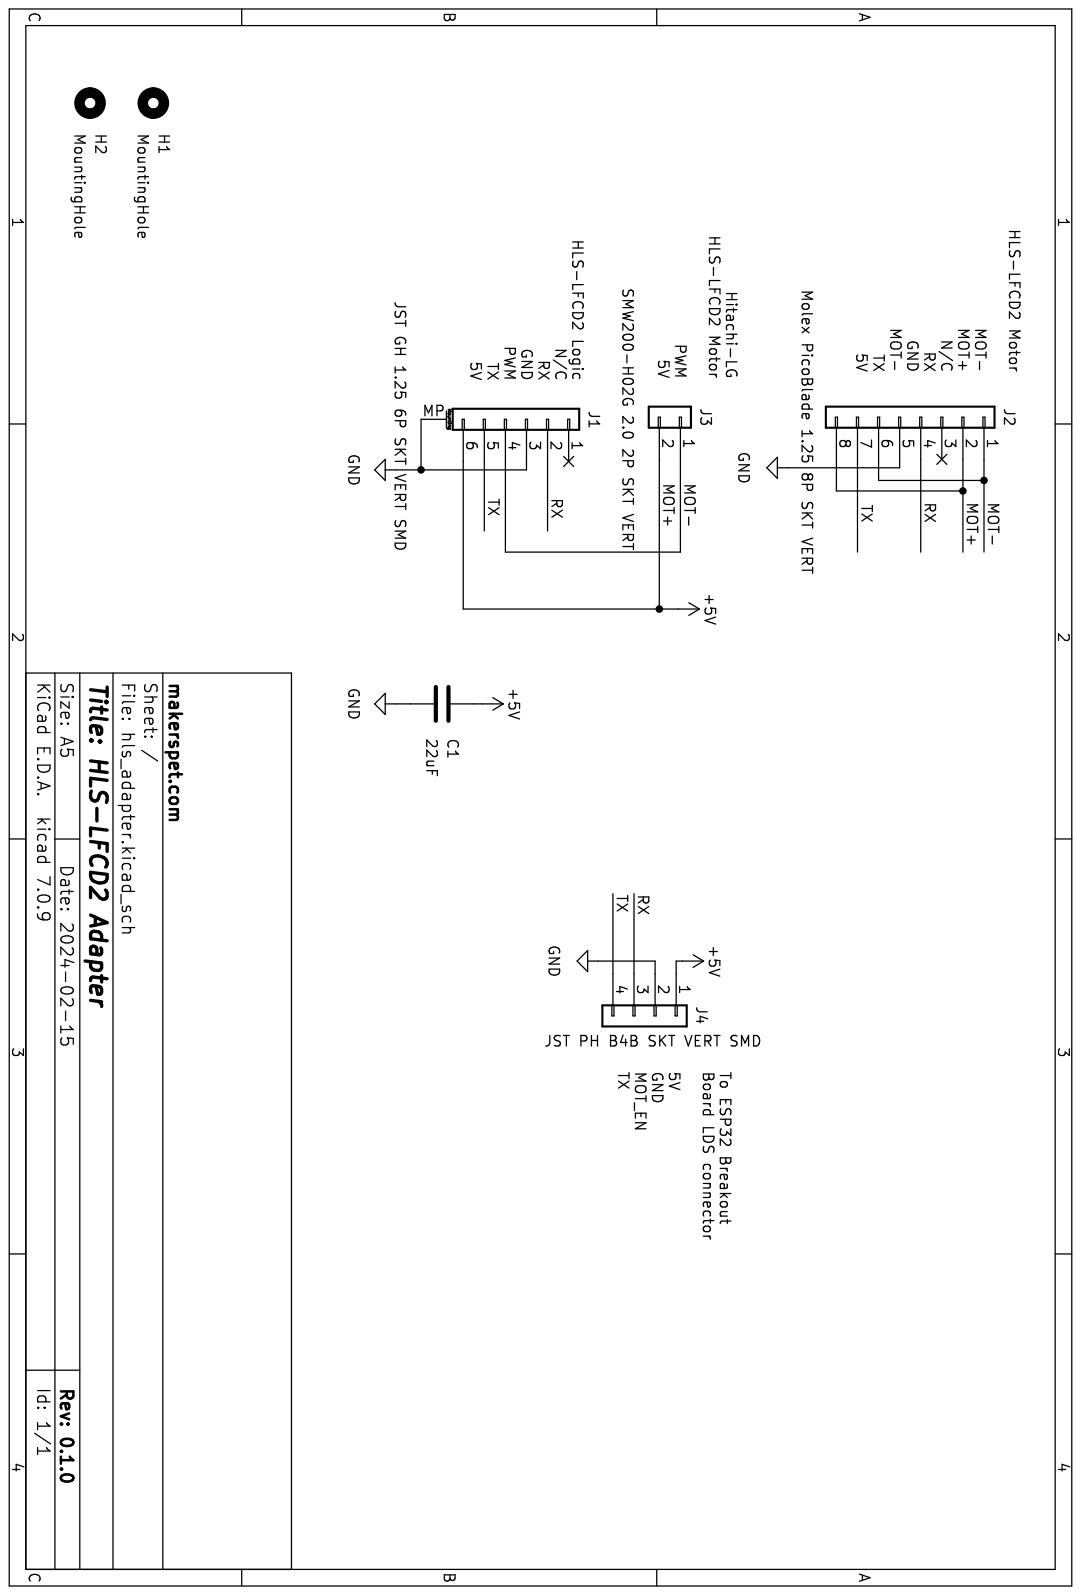
[picture p45: page 1]
