makerspet/pcb/neato_delta_adapter/output/neato_delta_adapter_schematic.pdf

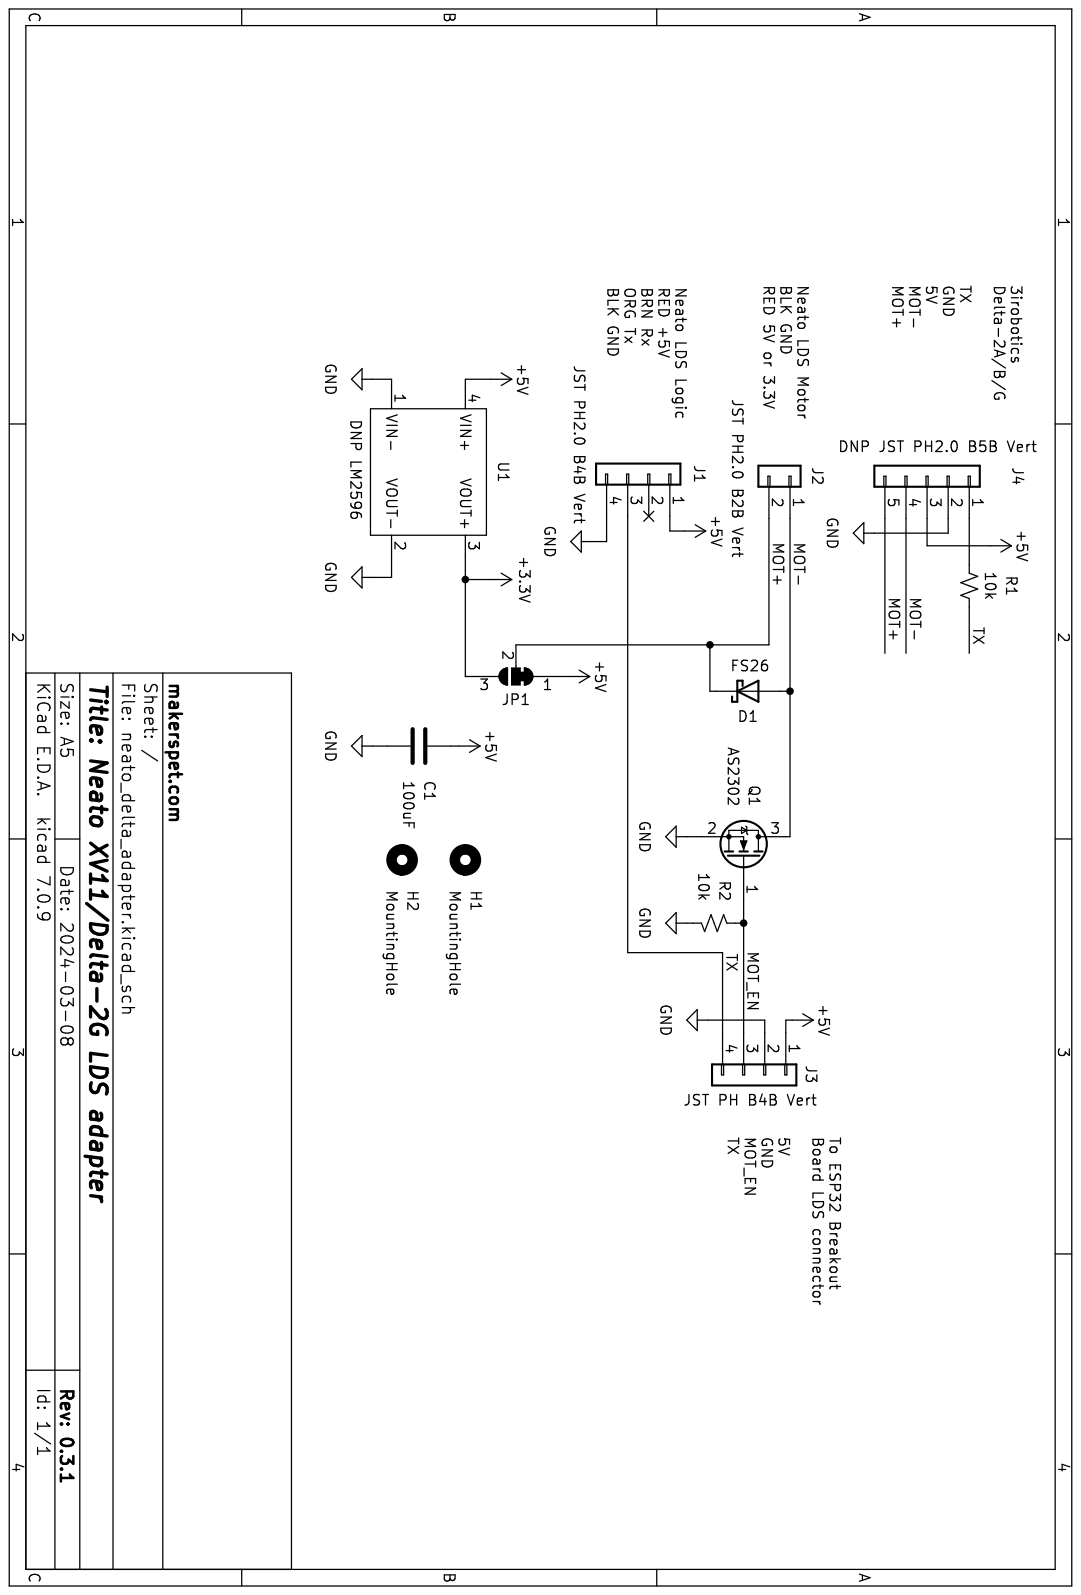
[picture p46: page 1]
