makerspet/pcb/lds02rr_adapter/output/LDS02RR_adapter_schematic.pdf

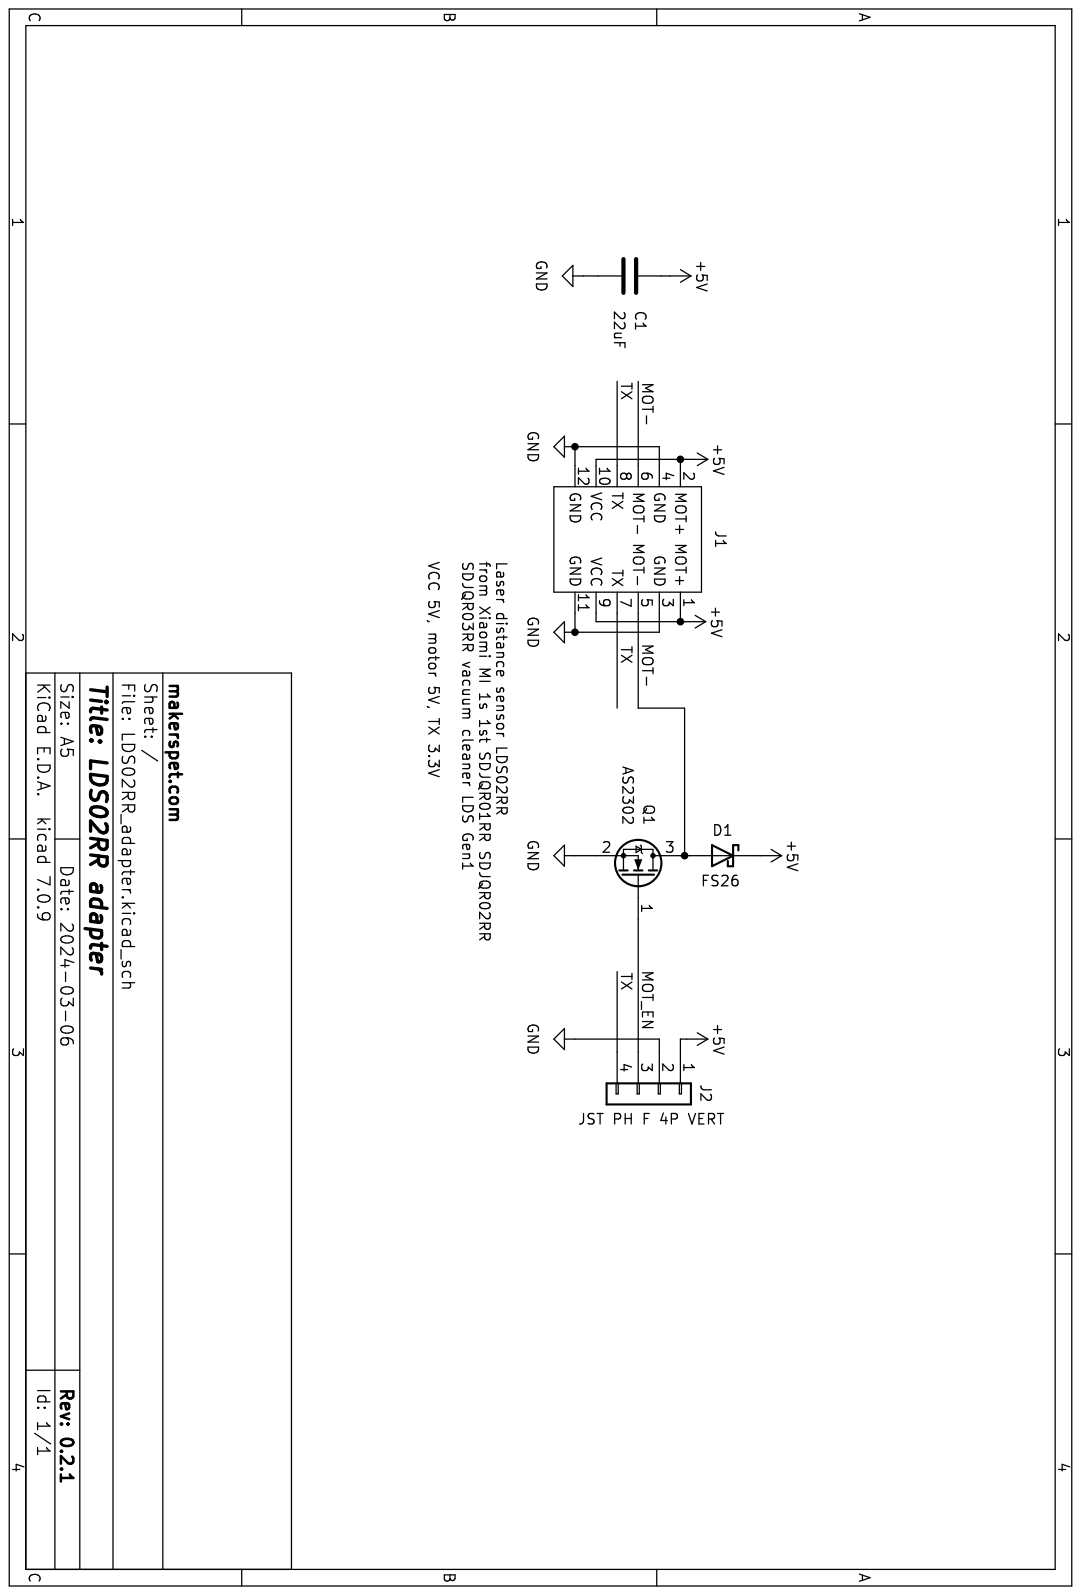
[picture p47: page 1]
