makerspet/pcb/(commit log)

2024-01-23 Snoopy copy
    [DCJ200-10-A-K1-K--3DModel-STEP-740395.STEP, DC_Power_Jack_PCB_Mounted_2.1mm.step, JST-B10B-ZR.step, JST-B11B-ZR.step, JST-B12B-ZR.step, JST-B13B-ZR.step, JST-B2B-ZR.step, JST-B3B-ZR.step]
2024-01-31 Neato, LDS02RR v0.2.0
    [LDS02RR_adapter.kicad_pcb, LDS02RR_adapter.kicad_sch, LDS02RR_adapter.step, LDS02RR_adapter_BOM.csv, Neato_adapter.kicad_pcb, Neato_adapter.kicad_sch, Neato_adapter_bom.csv]
2024-02-04 Started lds_breakout
    [NeatoXV11_Delta2G_adapter.kicad_pcb, NeatoXV11_Delta2G_adapter.kicad_sch, NeatoXV11_Delta2G_adapter_BoM.csv, esp32_breakout.kicad_sch, lds_breakout.kicad_pcb, lds_breakout.kicad_sch, lds_breakout_BoM.csv, neato_delta_adapter.kicad_pcb]
2024-02-13 SMW-200 model; HLS adapter
    [hls_adapter.kicad_pcb, hls_adapter.kicad_sch, hls_adapter_BoM.csv, smw200-02-socket-th-vertical.stp]
2024-02-15 HLS adapter schematic
    [hls_adapter.kicad_sch]
2024-02-16 HLS Adapter done
    [Molex_PicoBlade_53047_0810.stp, hls_adapter.kicad_pcb, hls_adapter.kicad_sch, hls_adapter_BoM.csv]
2024-03-07 0603 bypass cap
    [LDS02RR_adapter.kicad_pcb, LDS02RR_adapter.kicad_sch, LDS02RR_adapter.step, LDS02RR_adapter_BOM.csv]
2024-03-07 ZH extension connector; 6-pin LDS connector
    [esp32_breakout.kicad_pcb, esp32_breakout.kicad_sch, esp32_breakout_bom.csv, hls_adapter.kicad_pcb, hls_adapter.kicad_sch, hls_adapter.step, hls_adapter_BoM.csv, pico_breakout_head.kicad_pcb]
2024-03-08 Level shifter for Delta
    [neato_delta_adapter.kicad_pcb, neato_delta_adapter.kicad_sch, neato_delta_adapter_BoM.csv]
2024-03-09 Delta motor enable pulldown
    [neato_delta_adapter.kicad_pcb, neato_delta_adapter.kicad_sch, neato_delta_adapter_BoM.csv]
2024-03-12 12V motors
    [esp32_breakout.kicad_pcb, esp32_breakout.kicad_sch, esp32_breakout_bom.csv]
2024-03-18 Schematic notes
    [neato_delta_adapter.kicad_sch]
2024-03-19 Brushed, quad-encoder motors
    [esp32_breakout.kicad_pcb, esp32_breakout.kicad_sch, esp32_breakout_bom.csv]
2024-03-21 ZH connectors
    [esp32_breakout.kicad_pcb, esp32_breakout.kicad_sch, esp32_breakout_bom.csv]
2024-03-29 ESP32 combined schematic
    [PCB Terminal Block 2 DEG381-3.5.step, esp32_combined.kicad_pcb, esp32_combined.kicad_sch, esp32_combined_BoM.csv]
2024-03-30 Dual headers
    [esp32_combined.kicad_pcb, esp32_combined.kicad_sch]
2024-03-30 Labels space
    [esp32_combined.kicad_pcb]
2024-04-02 ESP32 Combined Gerber
    [esp32_combined.kicad_pcb, esp32_combined.kicad_sch, esp32_combined_BoM.csv]
2024-04-05 Mini560 PRO DC regulator
    [esp32_combined.kicad_pcb, esp32_combined.kicad_sch, esp32_combined_BoM.csv]
2024-04-06 Terminal blocks Combo
    [PCB_Terminal_Block_2-P3.5.step, PCB_Terminal_Block_3-P3.5.step, PCB_Terminal_Block_4-P3.5.step, PCB_Terminal_Block_6-P3.5.step, esp32_combined.kicad_pcb, esp32_combined.kicad_sch, esp32_combined_BoM.csv, esp32_combo.kicad_pcb]
2024-04-10 Match host socket to esp32_combo
    [pico_breakout_head.kicad_pcb, pico_breakout_head.kicad_sch, pico_breakout_head_bom.csv]
2024-04-17 Combo tweaks
    [esp32_breakout.kicad_sch, esp32_combo.kicad_pcb, esp32_combo.kicad_sch]
2024-04-18 1% resistor divider
    [esp32_combo.kicad_sch]
2024-04-23 Fuse silkscreen
    [esp32_combo.kicad_pcb]
2024-04-23 3A diode
    [esp32_combo.kicad_pcb, esp32_combo.kicad_sch]
2024-04-24 Motor direction bugfix
    [esp32_combo.kicad_pcb, esp32_combo.kicad_sch]
2024-04-27 Combo routed
    [esp32_combo.kicad_pcb, esp32_combo.kicad_sch, pico_breakout_head.kicad_sch]
2024-09-23 esp32_combo, pico_breakout_head
    [esp32_combo.kicad_pcb, esp32_combo.kicad_sch, esp32_combo_BoM.csv, esp32_comboh.kicad_pcb, esp32_comboh.kicad_sch, mini_combo.kicad_pcb, mini_combo.kicad_sch, pico_breakout_head.kicad_pcb]
